allanalderson/rtally/Schematic rTallyRx.pdf

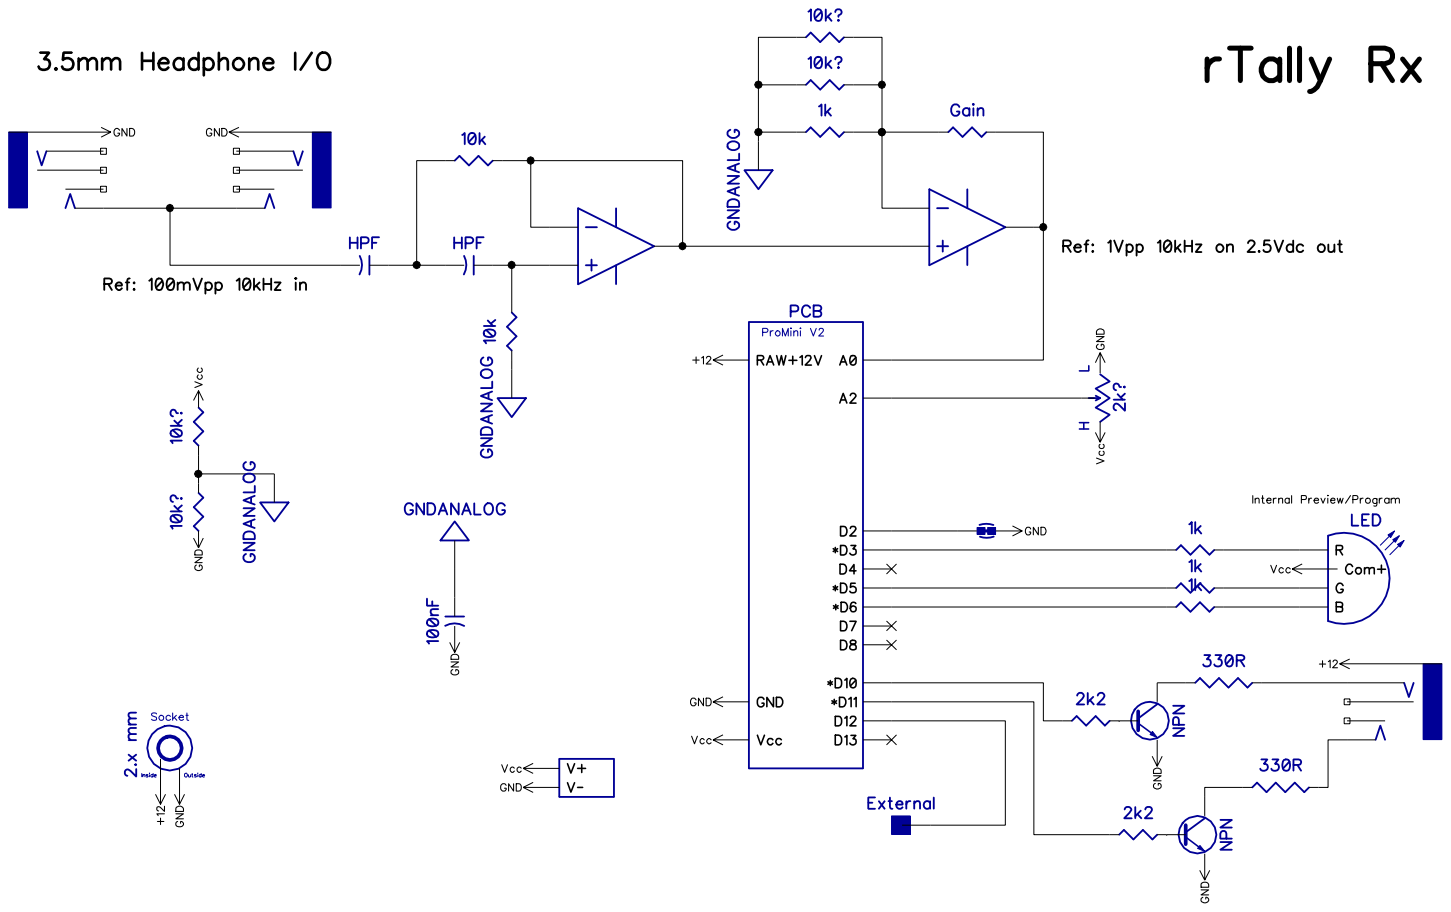
[picture p1: page 1]
