allanalderson/rtally/Schematic rTallyTX.pdf

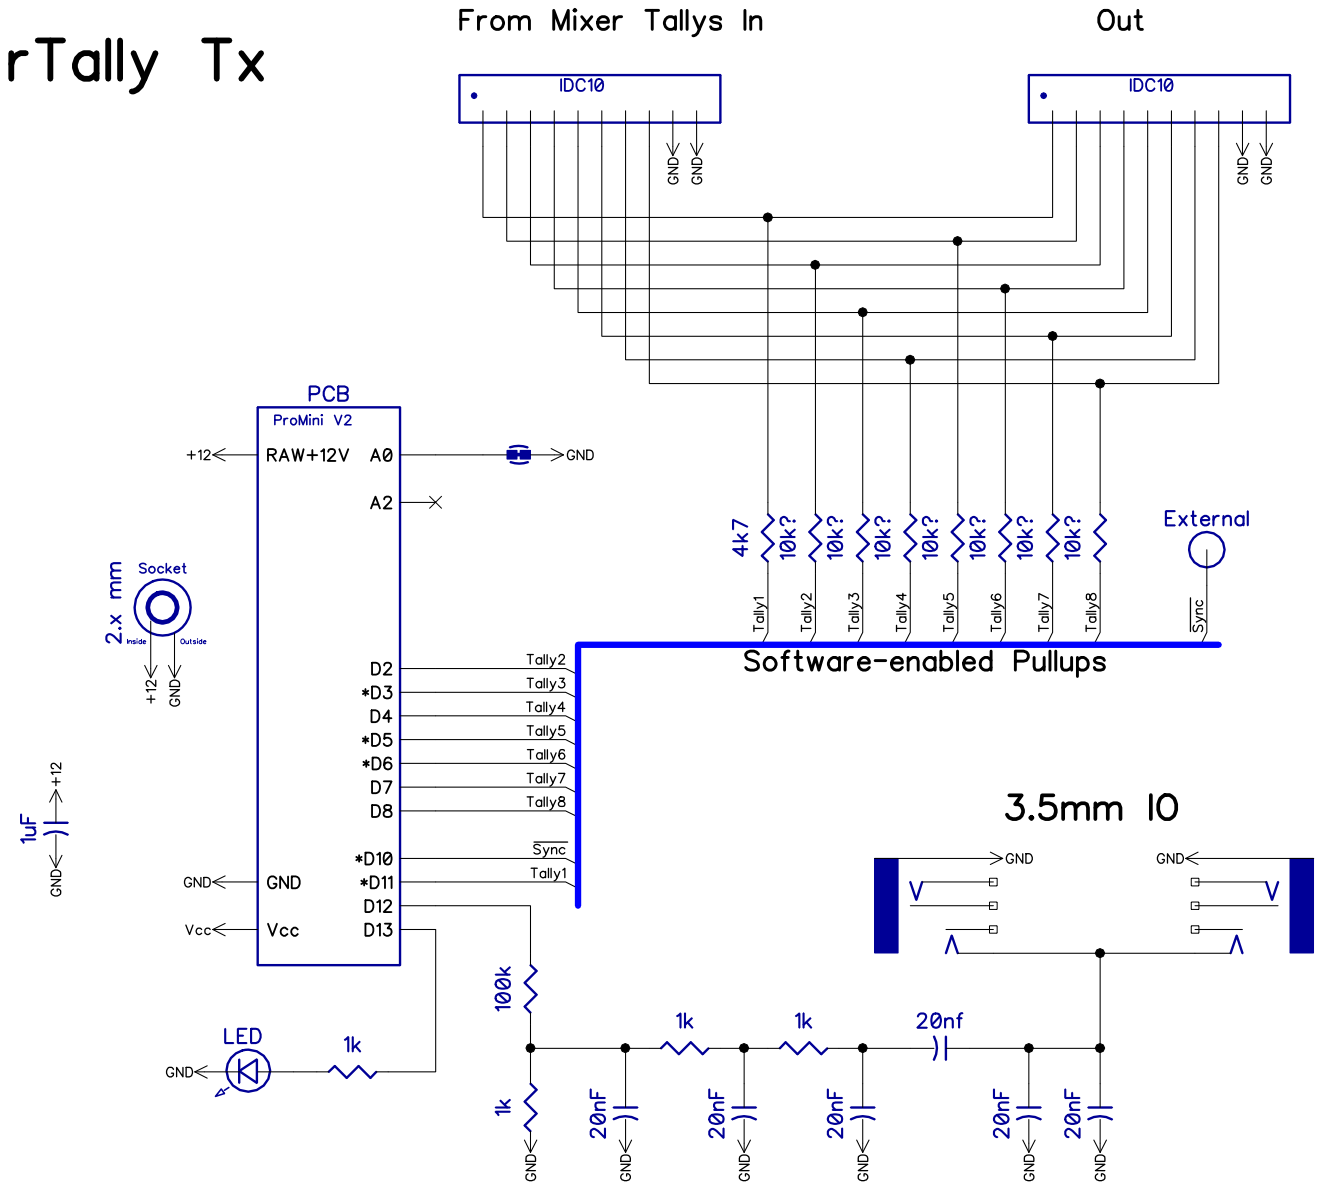
[picture p2: page 1]
