allanalderson/rtally/(commit log)

2018-12-03 Tx code
    Arduino IDE code for the Transmitter
2018-12-03 Rx code
    Arduino IDE code for the Receiver
2018-12-16 Updated Schematics
2018-12-16 Add files via upload
    Updated Schematics
2019-07-24 Create gerbers.zip
    rtall gerbers and drill files ready for PCB manufacture
2020-01-10 Arduino IDE friendly
    Put the Arduino code into the proper directories for the IDE.
2020-01-11 Renamed enclosing Arduino directory
2020-01-13 Pullup bug documented
    Pullup not possible on pin 11 and 8
    [input_data.ino, rTally_Tx.ino]
